ForzaDos/aging-meat-chamber-controller/paginas/bitacora.html

# Diario de secado

PARADA DE EMERGENCIA: los 6 relés están apagados y el control está suspendido, SIN protección de temperatura. Tocá REANUDAR TODO (arriba a la derecha) cuando el problema esté resuelto.

Tanda

Tanda en seguimiento

Nueva tanda Editar Borrar

Nombre

Fecha de inicio

Peso total (kg)

Merma objetivo (%)

Duración prevista (días)

### Receta de la cámara (a partir de qué día)

+ Agregar etapa

Notas (receta, tripa, curado...)

Guardar tandaCancelar

Piezas

Agregar pieza

Nombre

Entró a la cámara

Peso inicial (g)

Es pieza testigo (cuenta para la merma de la tanda)

Nota

Guardar piezaCancelar

Anotar el día

Fecha

Pieza

Peso hoy (g), si pesaste la pieza

Receta: temperatura (°C)

Receta: humedad (%)

Medida: temperatura (°C)

Medida: humedad (%)

Traer promedio medido por la cámara

Nota

Guardar registroCancelar edición

Lo que anotás acá es solo un registro: no cambia los objetivos de la cámara.

Diario

Gráficos

Merma Humedad Temperatura

Copia de seguridad y planilla

Descargar planilla (CSV) Descargar copia Restaurar copia Ordenar y compactar

El diario se guarda en la memoria de la placa y sobrevive a cortes de luz. Igual conviene bajar una copia de vez en cuando. Para abrir la planilla en Excel o Google Sheets usá el CSV.

Cámara de curado
