ForzaDos/aging-meat-chamber-controller/pagina.h

#pragma once
#include <Arduino.h>

// Página principal: monitoreo del secadero (HTML + CSS + JS). Chart.js se sirve desde el propio
// equipo (/chart.js): todo funciona sin internet. El diario es otra página (/bitacora), con pestañas.
// Los min/max de los deslizables tienen que coincidir con los rangos de hardware.h y web.cpp.
// GENERADO por paginas/generar.py a partir de paginas/principal.html: no editar a mano.
// 159841 bytes de HTML -> 45389 bytes con gzip.
const uint8_t PAGINA_HTML_GZ[] PROGMEM = {
0x1f,0x8b,0x08,0x00,0x00,0x00,0x00,0x00,0x02,0x0a,0xdc,0xbd,0xcb,0x92,0xdb,0x48,0x96,0x28,0xb8,0xd7,
0x57,0x78,0x52,0x99,0x4d,0xb2,0x44,0x42,0x24,0x83,0x11,0x0a,0x31,0xa4,0xa8,0x1b,0x92,0x22,0x53,0x1a,
0xd3,0xeb,0x2a,0x94,0xea,0x9e,0x51,0xcb,0x24,0x10,0x04,0x49,0x48,0x20,0xc0,0x04,0x40,0x2a,0x42,0x51,
0x61,0xd6,0xab,0xb1,0x9e,0xd5,0x98,0xf5,0xa6,0x37,0x33,0x8b,0xdc,0x8c,0x59,0x2d,0xd2,0xac,0x6b,0x6a,
0x71,0xcd,0x6a,0x33,0x66,0x15,0x7f,0x52,0x5f,0x32,0xe7,0xe1,0xee,0x70,0x07,0xc0,0x47,0x48,0xca,0xac,
0xb2,0x9b,0x0f,0x89,0x00,0xfc,0xed,0xc7,0xcf,0xfb,0x1c,0xbf,0xf3,0xcd,0x83,0x67,0xf7,0x5f,0xfe,0xaf,
0xcf,0x8f,0xc5,0x34,0x9b,0x85,0x87,0xd7,0xee,0xe0,0x5f,0x22,0x74,0xa3,0xc9,0xdd,0x9a,0x9f,0xd6,0xf0,
0x85,0xef,0x8e,0xe0,0xaf,0x99,0x9f,0xb9,0xc2,0x9b,0xba,0x49,0xea,0x67,0x77,0x6b,0x8b,0x6c,0xdc,0xde,
0xaf,0xa9,0xd7,0x91,0x3b,0xf3,0xef,0xd6,0x96,0x81,0xff,0x71,0x1e,0x27,0x59,0x4d,0x78,0x71,0x94,0xf9,
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
0x22,0xbf,0x3d,0xe5,0x42,0x5d,0xa7,0xb3,0x7b,0x71,0xcd,0x99,0xc6,0x89,0x7b,0x6e,0xef,0x09,0x80,0x7a,
0xf3,0x20,0x6f,0xbe,0xdb,0x57,0xcd,0x43,0x81,0x00,0xb6,0xbf,0x1d,0x2d,0x66,0x00,0x55,0xde,0x20,0x73,
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
};
