ForzaDos/aging-meat-chamber-controller/pagina_wifi.h

#pragma once
#include <Arduino.h>

// Página para elegir la red Wi-Fi (se sirve en /wifi).
// GENERADO por paginas/generar.py a partir de paginas/wifi.html: no editar a mano.
// 13753 bytes de HTML -> 5029 bytes con gzip.
const uint8_t PAGINA_WIFI_HTML_GZ[] PROGMEM = {
0x1f,0x8b,0x08,0x00,0x00,0x00,0x00,0x00,0x02,0x0a,0xb5,0x5b,0xdb,0x92,0xdb,0x46,0x92,0x7d,0xe7,0x57,
0x94,0x29,0x5b,0x20,0x6d,0x12,0x4d,0xb2,0x2f,0x6e,0x81,0xdd,0xed,0x95,0x25,0x7b,0x46,0x11,0xb6,0x47,
0xe1,0xd6,0xec,0x25,0xbc,0x8a,0x9d,0x02,0x50,0x20,0xcb,0x0d,0x02,0x70,0x01,0xe8,0x8b,0x38,0x8c,0xd8,
0x7f,0xd8,0x2f,0xd0,0xa3,0x1f,0xf6,0x61,0xc3,0x0f,0x1b,0x31,0x2f,0x1b,0x31,0xfd,0x27,0xfb,0x25,0x7b,
0xb2,0xaa,0x40,0x02,0x68,0xb4,0xd4,0x72,0x68,0x27,0x66,0xd4,0x40,0x5d,0xb2,0xb2,0xb2,0x32,0x4f,0x9e,
0x2c,0x70,0x4e,0x3e,0x79,0xfe,0xa7,0x67,0xaf,0xfe,0xe5,0xe5,0x37,0x6c,0x59,0xac,0xe2,0xb3,0xde,0x09,
0xfd,0x61,0x31,0x4f,0x16,0xa7,0x7d,0x91,0xf7,0xa9,0x41,0xf0,0x10,0x7f,0x56,0xa2,0xe0,0x2c,0x58,0x72,
0x95,0x8b,0xe2,0xb4,0x5f,0x16,0xd1,0xf8,0xb8,0x5f,0x35,0x27,0x7c,0x25,0x4e,0xfb,0x97,0x52,0x5c,0x65,
0xa9,0x2a,0xfa,0x2c,0x48,0x93,0x42,0x24,0x18,0x76,0x25,0xc3,0x62,0x79,0x1a,0x8a,0x4b,0x19,0x88,0xb1,
0x7e,0x19,0xc9,0x44,0x16,0x92,0xc7,0xe3,0x3c,0xe0,0xb1,0x38,0x9d,0x8e,0xaa,0x59,0xe3,0x48,0x16,0xa7,
0x41,0x7a,0x29,0x54,0x4b,0x6c,0xb1,0x14,0x2b,0x31,0x0e,0xd2,0x38,0x55,0x35,0xc9,0x8f,0x26,0xd1,0x74,
0x36,0x3d,0xa2,0xb1,0x85,0x2c,0x62,0x71,0xf6,0xa3,0x08,0xd9,0x3f,0xc9,0xf1,0xb7,0xf2,0x64,0xcf,0x34,
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
0x06,0xf9,0x90,0x43,0xd7,0xe7,0x3b,0x69,0x9d,0xef,0xa4,0x3a,0x58,0xad,0x61,0xe7,0xfe,0xec,0x52,0x5e,
0x24,0x55,0x5e,0x8c,0xd3,0x68,0x5c,0xdc,0x64,0x62,0x5d,0x9b,0x36,0xb1,0x23,0x18,0xd6,0x4b,0xd6,0x77,
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
};
