ForzaDos/aging-meat-chamber-controller/pagina_bitacora.h

#pragma once
#include <Arduino.h>

// Página del diario de secado (HTML + CSS + JS). Se sirve en /bitacora.
// Chart.js se sirve desde el propio equipo (/chart.js): todo funciona sin internet.
// GENERADO por paginas/generar.py a partir de paginas/bitacora.html: no editar a mano.
// 52021 bytes de HTML -> 16227 bytes con gzip.
const uint8_t PAGINA_BITACORA_HTML_GZ[] PROGMEM = {
0x1f,0x8b,0x08,0x00,0x00,0x00,0x00,0x00,0x02,0x0a,0xbd,0x7d,0xdb,0x72,0xdb,0xc8,0x92,0xe0,0xbb,0xbe,
0xa2,0x4c,0xb7,0x0f,0x81,0x36,0x09,0x91,0xd4,0xa5,0x65,0x52,0x92,0x57,0x6d,0xb9,0x2f,0xb3,0x76,0x5b,
0x2b,0xbb,0xcf,0xce,0x86,0x8e,0xb6,0x0d,0x12,0x45,0x12,0x16,0x08,0xc0,0x00,0xa8,0x8b,0x39,0xdc,0xd8,
0xa7,0xfd,0x80,0xdd,0x87,0x7d,0xee,0xc7,0x7e,0xe8,0x88,0x99,0x38,0x0f,0x1b,0x31,0xfb,0x30,0x11,0x47,
0x7f,0x32,0x3f,0xb0,0xbf,0xb0,0x99,0x59,0x17,0x14,0x2e,0x94,0x28,0xb7,0x67,0x7a,0xe6,0x58,0x44,0xa1,
0x2e,0x59,0x59,0x59,0x79,0xab,0xac,0xc4,0xfe,0xa3,0xe3,0x37,0x2f,0xde,0xfd,0x97,0x93,0x97,0x6c,0x9a,
0xcd,0x82,0xc3,0x8d,0x7d,0xfc,0xc3,0x02,0x37,0x9c,0x1c,0x34,0x78,0xda,0xc0,0x02,0xee,0x7a,0xf0,0x67,
0xc6,0x33,0x97,0x8d,0xa6,0x6e,0x92,0xf2,0xec,0xa0,0x31,0xcf,0xc6,0xed,0xbd,0x86,0x2a,0x0e,0xdd,0x19,
0x3f,0x68,0x5c,0xfa,0xfc,0x2a,0x8e,0x92,0xac,0xc1,0x46,0x51,0x98,0xf1,0x10,0xaa,0x5d,0xf9,0x5e,0x36,
0x3d,0xf0,0xf8,0xa5,0x3f,0xe2,0x6d,0x7a,0x68,0xf9,0xa1,0x9f,0xf9,0x6e,0xd0,0x4e,0x47,0x6e,0xc0,0x0f,
0xba,0x2d,0xd5,0xaa,0x3d,0xf6,0xb3,0x83,0x51,0x74,0xc9,0x93,0x52,0xb7,0xd9,0x94,0xcf,0x78,0x7b,0x14,
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
0xb3,0x4b,0x3f,0xf5,0x87,0x01,0xb4,0x70,0x93,0xc4,0x1f,0xba,0x0e,0xfb,0x7a,0x73,0xc3,0x89,0x71,0x88,
0xd0,0x4d,0x17,0x71,0x94,0xc2,0x66,0x07,0xda,0x06,0x9c,0x8d,0x2e,0x6e,0x06,0xb0,0x04,0x40,0x60,0x9f,
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
};
