ForzaDos/aging-meat-chamber-controller/chartjs_gz.h

#pragma once
#include <Arduino.h>

// Chart.js 4.4.7 (MIT, https://www.chartjs.org) comprimido con gzip, incluido en el programa
// para que los gráficos funcionen sin internet. Se sirve en /chart.js.
const size_t CHARTJS_GZ_LEN = 69563;
const uint8_t CHARTJS_GZ[] PROGMEM = {
0x1f,0x8b,0x08,0x00,0x00,0x00,0x00,0x00,0x02,0xff,0xd4,0xbd,0x6b,0x77,0xdb,0x36,0xd3,0x28,0xfa,0x7d,
0xff,0x0a,0x5b,0x6f,0xe3,0x92,0x16,0x24,0x4b,0x8a,0x9d,0x0b,0x65,0x5a,0x3b,0xd7,0x26,0x6d,0x12,0xa7,
0x71,0x9a,0x5e,0xfc,0x68,0xfb,0xa1,0x44,0xc8,0x42,0x43,0x93,0x2a,0x01,0xd9,0x56,0x65,0xfd,0xf7,0x33,
0x33,0xb8,0x10,0x94,0xe4,0x3c,0x7d,0xd7,0xbb,0xf6,0x59,0xe7,0x34,0xab,0x16,0x09,0x80,0xb8,0x0c,0x06,
0x83,0xc1,0x60,0x2e,0x07,0xfb,0xbb,0xff,0x6b,0x67,0x7f,0xe7,0xc5,0x34,0x29,0x55,0xfb,0x4f,0xb9,0x73,
0x7d,0xd8,0x3e,0x6c,0x3f,0xc6,0xa4,0xa9,0x52,0x33,0x19,0x1d,0x1c,0xdc,0xdc,0xdc,0xb4,0xc7,0x98,0xfd,
0xa7,0x6c,0x17,0xe5,0x25,0x66,0x05,0xe3,0x70,0xa7,0xd7,0xe9,0x1d,0x56,0x9f,0xbd,0x28,0x72,0x55,0x8a,
0xd1,0x5c,0x15,0xa5,0xc4,0x12,0x9f,0x78,0xc6,0x13,0xc9,0xd3,0x9d,0x79,0x9e,0xf2,0x72,0x47,0x4d,0xf9,
0xce,0xfb,0xb7,0x9f,0x77,0xde,0x89,0x31,0xcf,0x25,0x87,0x12,0x07,0xff,0x6b,0x77,0x32,0xcf,0xc7,0x4a,
0x14,0x79,0xa0,0x18,0x0f,0x97,0x8d,0x62,0xf4,0x27,0x1f,0xab,0x46,0x1c,0xab,0xc5,0x8c,0x17,0x93,0x1d,
0x7e,0x3b,0x2b,0x4a,0x25,0xf7,0xf6,0x1a,0x58,0xc7,0x44,0xe4,0x3c,0x6d,0xec,0xda,0xcc,0xab,0x22,0x9d,
0x67,0x7c,0xa0,0x7f,0xda,0xa6,0x68,0xcc,0x83,0x30,0x6a,0xd8,0x6a,0xab,0x9a,0xf4,0xd7,0x7b,0x7b,0xfa,
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
0xaf,0x37,0x9e,0x89,0x9e,0x49,0x1c,0x0b,0x0c,0x8a,0xe5,0xac,0xc0,0xd1,0xec,0x02,0xbe,0xec,0x72,0xc0,
0x19,0x53,0xe5,0x2e,0x22,0xb2,0x7e,0xb4,0xeb,0xa5,0xdb,0xc7,0x6e,0x88,0xb8,0xc3,0xa4,0x1b,0x72,0x5f,
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
};
