ForzaDos/aging-meat-chamber-controller/(commit log)

2026-10-30 Camara de curado: controlador para una heladera de secado de chacinados (ESP32)
    Proyecto de un aficionado a la charcuteria, compartido como codigo abierto (MIT): controla temperatura, humedad, ventilacion y dos salidas auxiliares con una ESP32, y se maneja desde el celular. Incluye balanza opcional para la pieza testigo, diario de secado, parada de emergencia y actualizacion por Wi-Fi.
    [partitions.csv]
2026-10-30 Pulsador de emergencia redondo en la web (v1.0.7)
    El boton APAGAR TODO ahora es un pulsador redondo con aro amarillo, que se ve hundido y con el aro parpadeando cuando la parada esta activa. Se actualiza la foto del README.
2026-10-30 Boton APAGAR TODO rectangular y mas abajo (v1.0.8); correcciones de ortografia del README
    El pulsador redondo no convencio: ahora es un boton rectangular con borde de franjas amarillas y negras, debajo de las lecturas y visible en todas las pestanas. Se corrigen los errores de ortografia y gramatica del README y se actualiza la foto.
    [config.h, pagina.h]
2026-10-30 APAGAR TODO en la barra de pestanas (v1.0.10)
    El boton rectangular pasa a la barra de pestanas, que queda fija arriba: en el celular en una fila propia debajo de las pestanas y en pantallas anchas como una quinta pestana. Se actualiza la foto del README.
2026-10-30 Versiones 1.0.11 a 1.0.15: parada resaltada en el registro, botones de la barra, test sin espera, diagnostico
    APAGAR TODO chico y ultimo de la barra (tambien en el Diario), Pausar discreto en verde claro, parada resaltada en el registro y en el grafico, test de reles sin cuenta atras, /api/coredump, motivos de watchdog separados, Reiniciar en naranja con confirmacion escrita, textos de borrado mas claros.
2026-10-30 plan: causa del cuelgue del 30/10 y decision de no arreglarlo por ahora
2026-10-30 v1.0.16: la pestaña Balanza ya no desaparece unos segundos en el Diario de secado
2026-11-03 v1.0.17 a v1.0.22: dos balanzas, vigia de la web y revision
    - Dos balanzas (1 kg y 10 kg): tabla BALANZAS[] en hardware.h, una tarea las recorre,
    cada una con su seguimiento, su archivo de historial y su espacio de NVS.
    API /api/balanzas y ?i=N; los POST exigen i. La camara comprueba quien contesta
    (campo host en /api/peso) y descarta la IP si es otra placa.
    - Web: el peso de las dos se ve siempre, selector 1 kg / 10 kg para los paneles,
    graficos con una curva por balanza y casillas para prender o apagar cada una.
    - LCD: Menu > Balanza muestra las dos y elige cual se opera.
    - Rendimiento: la tarea de balanzas corre con prioridad 0 y busca por mDNS cada 60 s
    si una no contesta (la w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
2026-11-03 README: hasta dos balanzas y link al repositorio de las balanzas
2026-11-03 Paginas con la estetica del hub: tarjetas, iconos de equipos y graficos con degrade
2026-11-03 Regla de temperatura: la franja muestra la histeresis (objetivo a objetivo + histeresis), no la banda de alarma
2026-11-03 v1.0.23: histeresis superior e inferior independientes, franja en el grafico y boton para ocultar los valores flotantes
2026-11-03 v1.0.24: rangos de 6 y 12 horas en el grafico y borrado del historial de 1 mes o 3 meses
2026-11-04 v1.0.25: histeresis con botones, sliders de perilla, leyendas de tiempos de proteccion, escala vertical Auto/x2/x4 y grafico sin degradado
2026-11-04 v1.0.26: espera de confirmacion para prender humidificador y deshumidificador, histeresis de humedad hasta 40 %
2026-11-04 v1.0.31: perfiles de setpoints, punto de acceso Wi-Fi fijable, humidificador y deshumidificador apagables
    Perfiles de setpoints (v1.0.28-30): cuatro casilleros con nombre editable (objetivos, histeresis, esperas y ventilador), se cargan, se guardan y se editan sin tocar la camara. Los nombres se cambian desde el detalle de cada perfil.
    v1.0.31: la camara se puede fijar a un punto de acceso (BSSID) desde /wifi, con respaldo a cualquiera a los 20 s (con un repetidor de mismo nombre alternaba entre dos caminos). El humidificador y el deshumidificador se pueden dejar apagados (humOff/deshOff, en Setpoints y en cada perfil). El zoom x2/x4 del grafico ahora tambien actua sobre la humedad. /api/di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
2026-11-04 Nota: la camara queda fijada al punto de acceso del repetidor
2026-11-04 v1.0.34: la camara elige sola el mejor Wi-Fi y diagnostico del sensor
    v1.0.34: al conectar escanea todos los canales y elige el punto de acceso de mejor senal; ya conectada, cada 5 min revisa y se pasa a otro del mismo nombre si es al menos 10 dB mejor (respaldo a los 25 s si el elegido no deja conectar). Soltar el punto de acceso fijado ya no corta la conexion.
    v1.0.33: diagnostico del sensor DHT22 en /api/diag (lecturas, fallas, racha, caidas, fallas tras cambio de relé, ultima lectura buena, nivel del pin) y en Ajustes > Diagnostico.
    v1.0.32: estando en otro punto de acceso que el fijado, reintenta el fijado cada 5 min en vez de 30.
2026-11-04 v1.0.35: NO SE USA en la web y el LCD, y la etapa cargada en el menu del LCD
    Cuando el humidificador o el deshumidificador estan apagados a pedido (casilla de Setpoints o perfil), la web de la camara lo marca como NO SE USA en la fila de Salidas, y el LCD muestra una fila de solo lectura arriba del submenu Humedad (Humidif: NO SE USA / Deshum.: NO SE USA / Hum/Desh NO SE USA / en uso).
    El menu principal del LCD muestra la etapa (perfil) cargada en su primera fila: Etapa: Estufado, con * si se cambio algo despues de cargarlo, o Etapa: ninguna. Solo lectura; la pantalla principal no se toca. El ultimo perfil cargado o guardado se recuerda en la memoria permanente (perfCarg). Manual del LCD re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
2026-11-05 v1.0.36 a v1.0.39: LCD editable, cargar perfil, humidificador sin vapor de mas
    - v1.0.36/37: "NO SE USA" editable desde el LCD y Menu > Cargar perfil (doble confirmacion).
    - v1.0.38: regla inviolable, humidificador y deshumidificador nunca juntos (barrera en aplicar(),
    red de seguridad en el loop, test avanzado desactivado).
    - v1.0.39: humidificador con pulso corto, descanso obligatorio, bloqueo despues del frio, valvula
    con piso ajustable y promedio lento; web, LCD y perfiles. Se sacan el minimo encendido y la
    alarma de desvio de temperatura. El deshumidificador no cambia.
